thiago9800/tcc-curso-tecnico-senai/README.md

# tcc curso tecnico senai

## obijetivo do projeto:
```
A funcionalidade do projeto constitui-se em manipular uma matriz de LED (Light Emitting Diode) 8x8 
através de um app celular via Bluetooth que exibirá imagens em Bitmap conforme a escolha do usuário

```
